FornaxRRSC/RCJ2025_Hardware/README.md

# Hardware

機体に搭載している基板のリポジトリです。  
それぞれの基板の解説は<https://fornax-rrsc.com>に掲載しています。

## 既知の欠陥

最新の基板の欠陥のみ記載
* MainBoard Rev.3のSTM32H723とSTM32F446間のUARTがTX,RX同士をつないでいる
* MainBoard Rev.3のオペアンプのフットプリントが間違っている

## License

**CERN-OHL-P v2**
