FornaxRRSC/RCJ2025_Hardware/TileBoard-Rev2.step

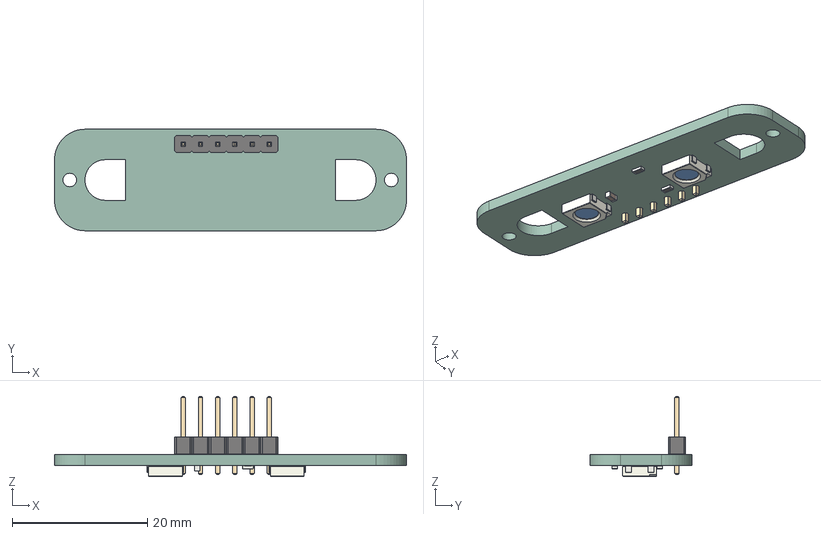
[picture p1: CAD file, 2025-05-13]
TileBoard-Rev2.step
52.0 x 15.0 x 11.8 mm
PinHeader_1x06_P254mm_Vertical
LED_WS2812B_PLCC4_50x50mm_P32mm x 2
R_0603_1608Metric x 2
C_0603_1608Metric
_autosave-Final_PCB
