FornaxRRSC/RCJ2025_Hardware/Final.kicad_pcb

## KiCad design Final.kicad_pcb (2025-05-13)

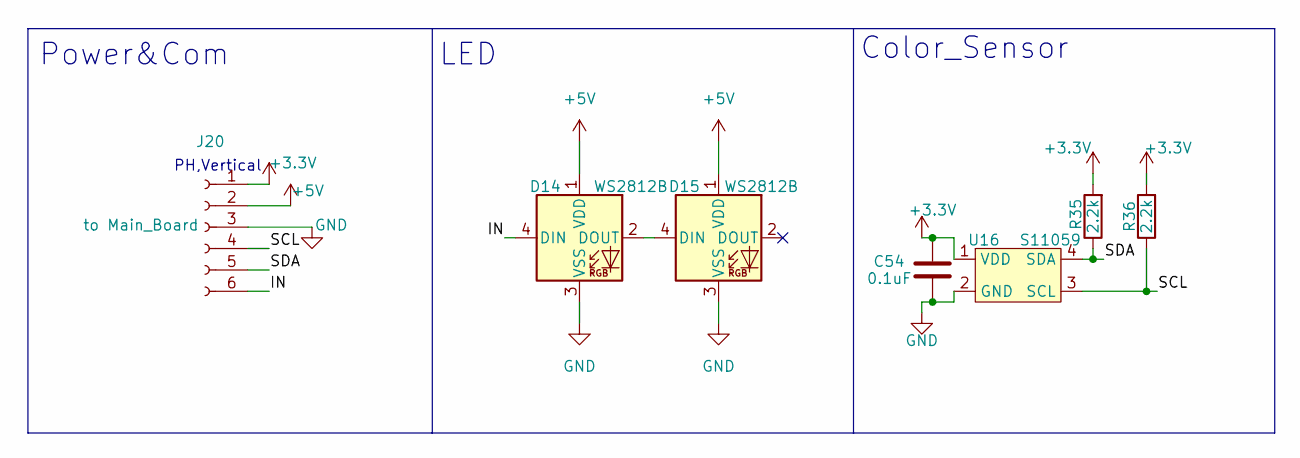
[picture p2: schematic TileBoard.kicad_sch]

Parts:
C54: 0.1uF; C_0603_1608Metric
D14, D15: WS2812B; LED_WS2812B_PLCC4_5.0x5.0mm_P3.2mm
J20: to Main_Board; PinHeader_1x06_P2.54mm_Vertical
R35, R36: 2.2k; R_0603_1608Metric
U16: S11059

Connections:
+3.3V: C54.1, J20.1, R35.2, R36.2, U16.1 (VDD); also elsewhere on the board
+5V: D14.1 (VDD), D15.1 (VDD), J20.2; also elsewhere on the board
/Tile_Board/IN: D14.4 (DIN), J20.6
/Tile_Board/SCL: J20.4, R36.1, U16.3 (SCL)
/Tile_Board/SDA: J20.5, R35.1, U16.4 (SDA)
GND: C54.2, D14.3 (VSS), D15.3 (VSS), J20.3, U16.2 (GND); also elsewhere on the board
unnamed: D14.2 (DOUT), D15.4 (DIN)

Notes on the sheet:
Color_Sensor
LED
Power&Com
PH,Vertical

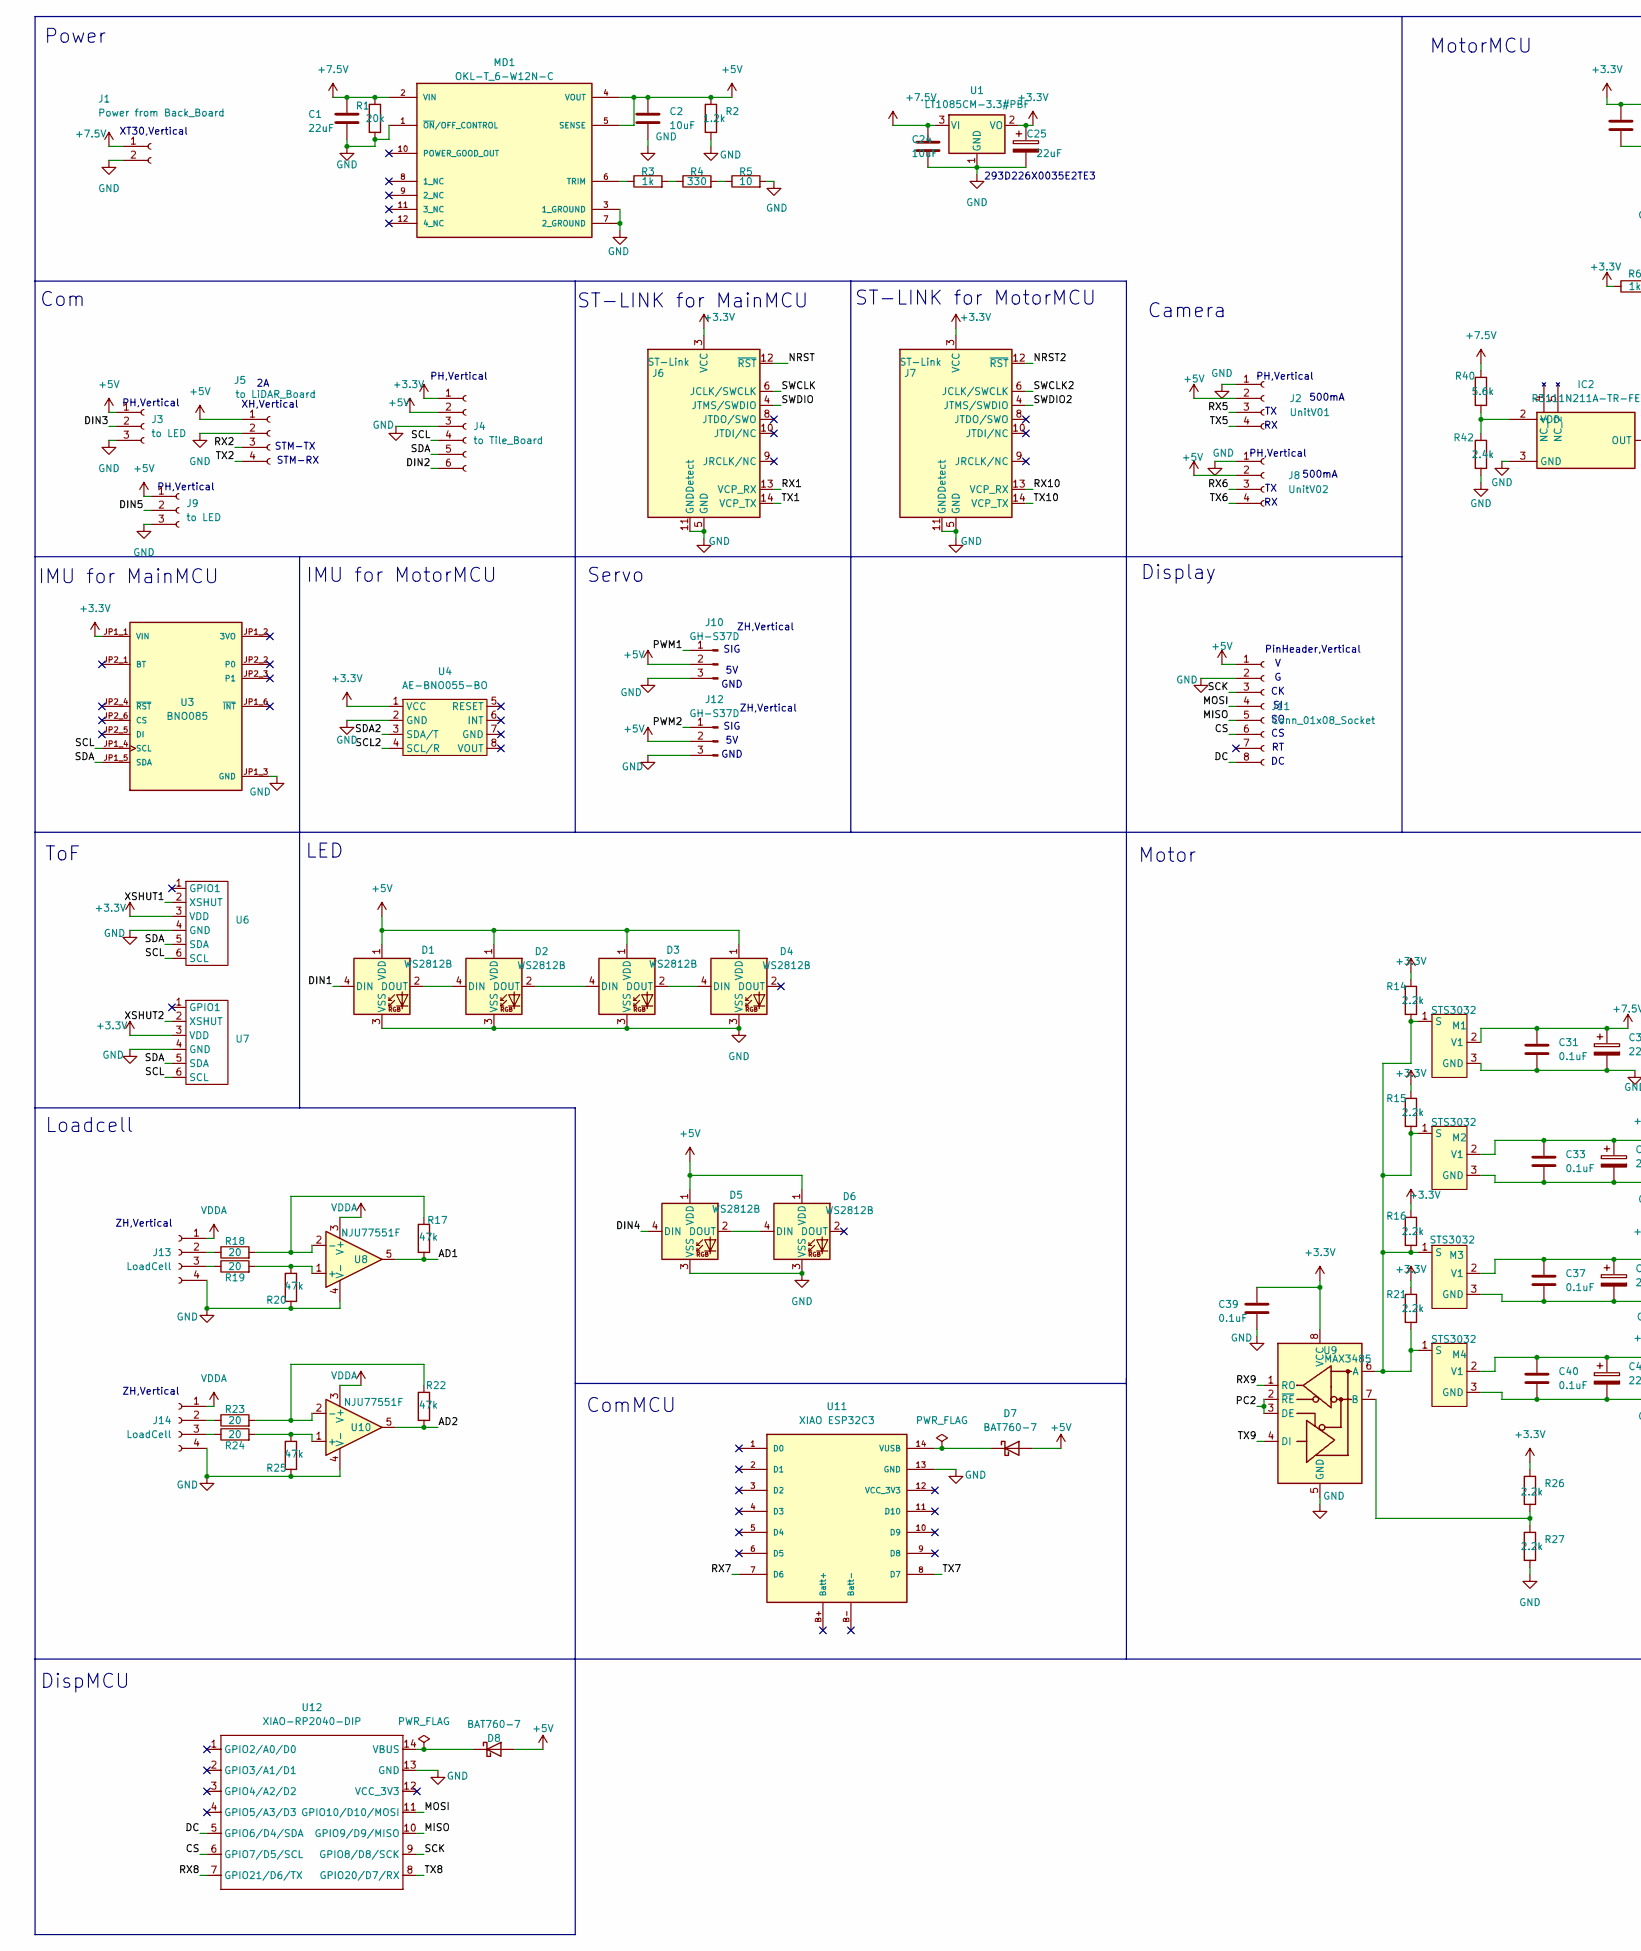
[picture p3: schematic MainBoard.kicad_sch, part in row 1, column 1]

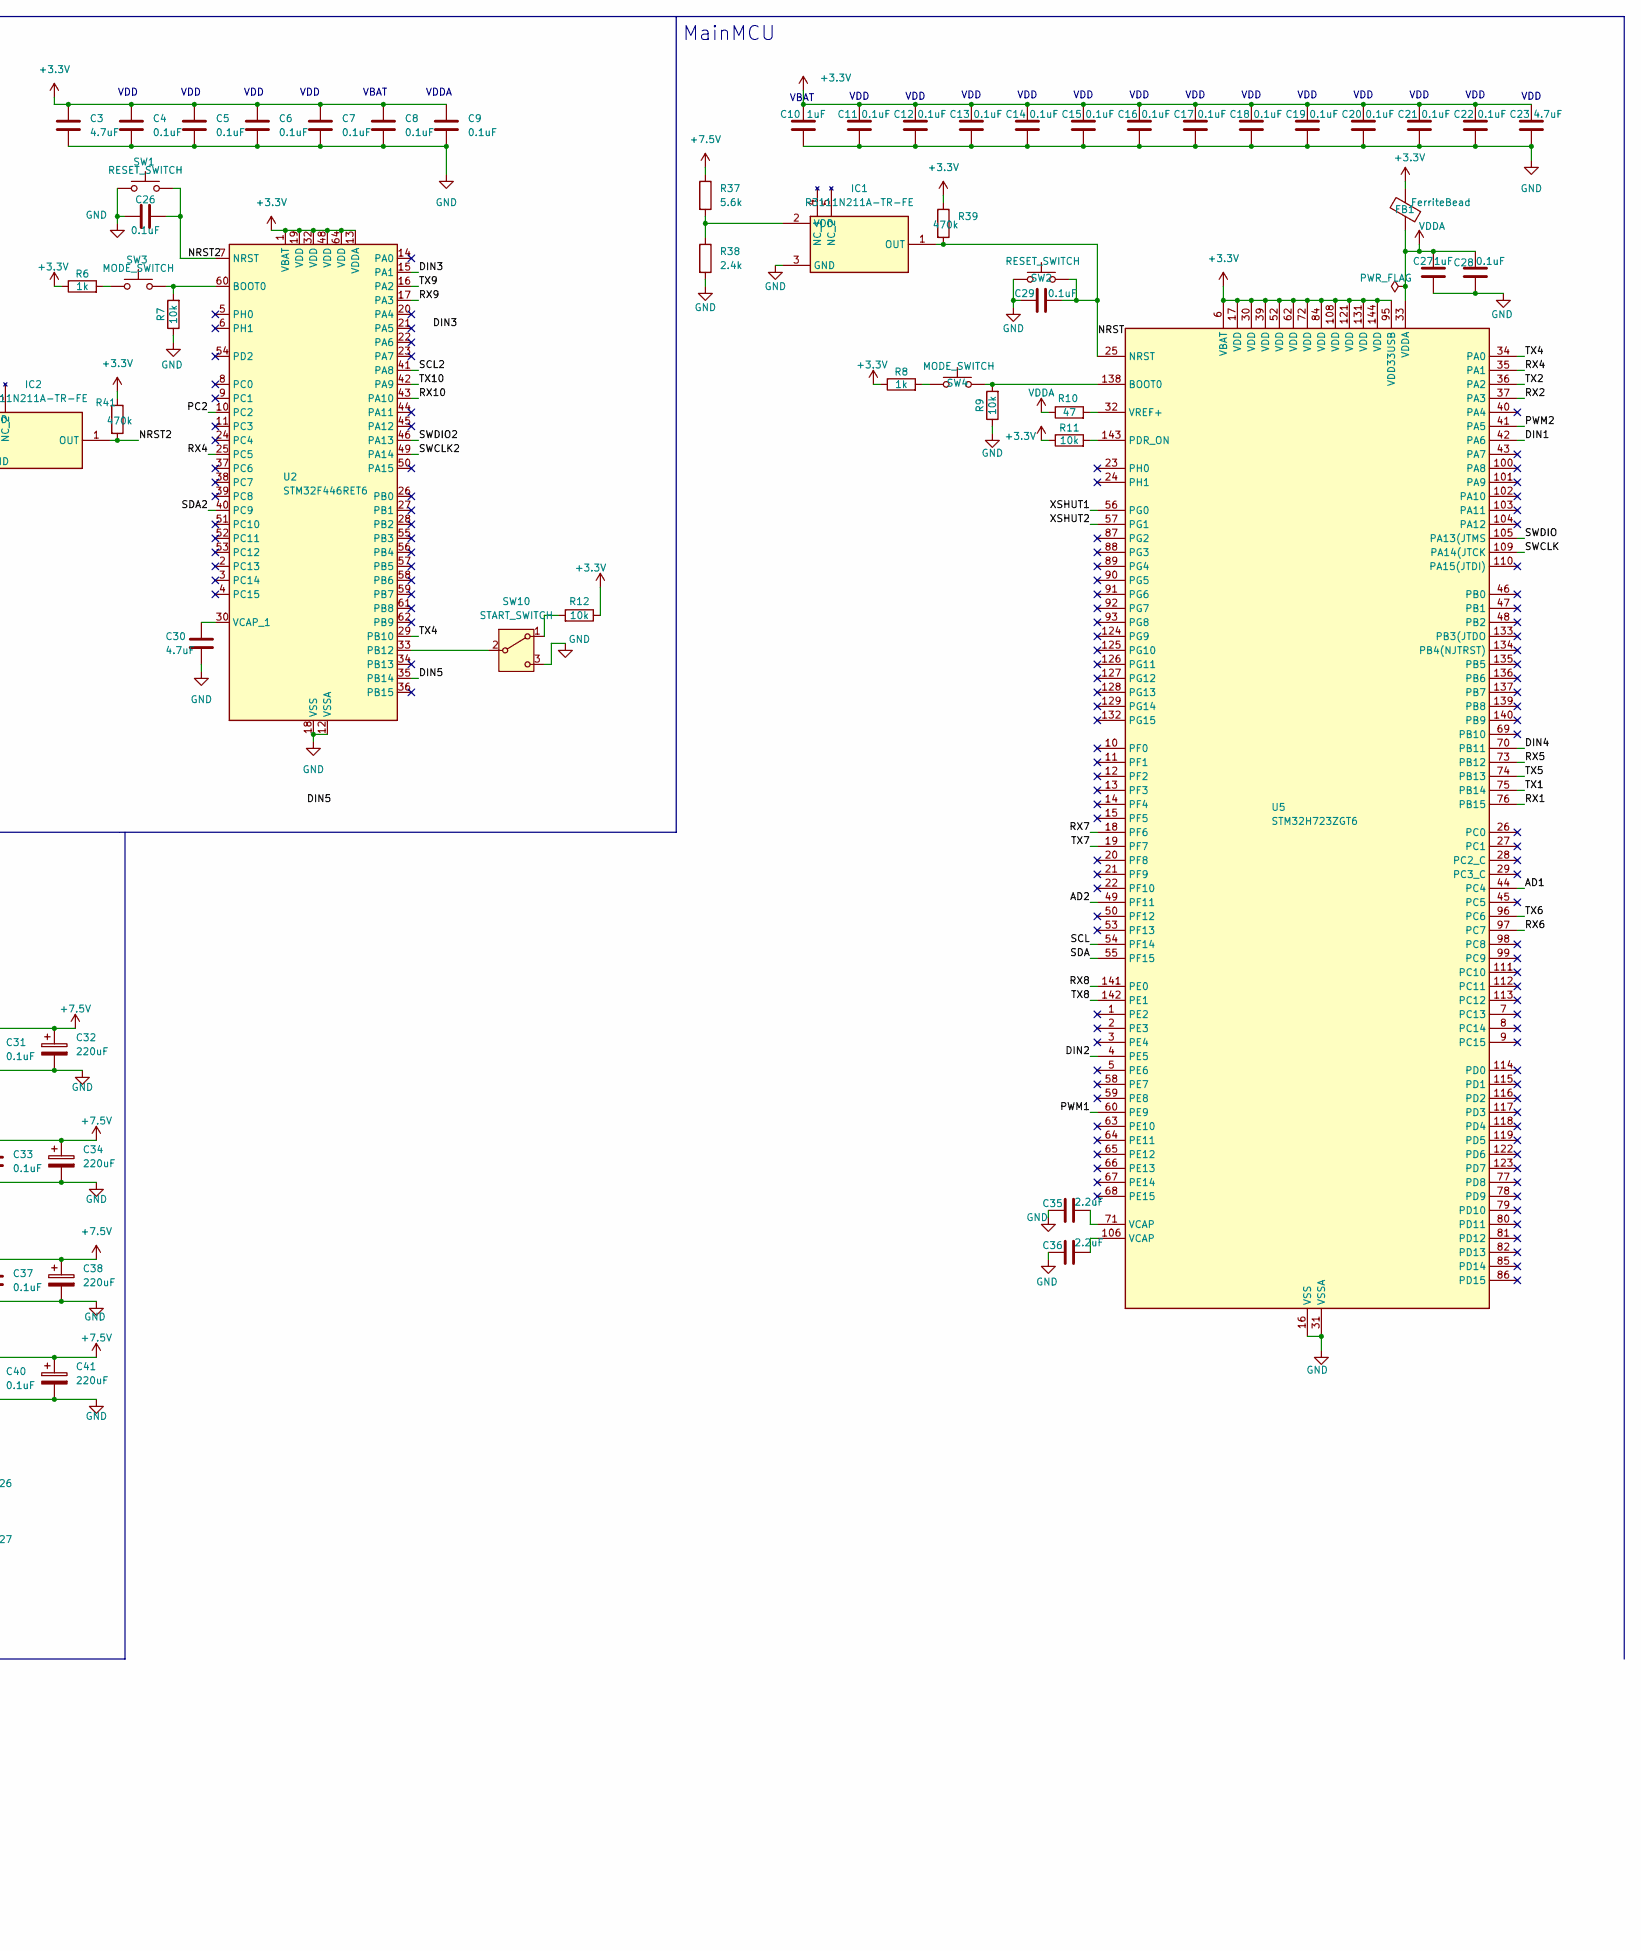
[picture p4: schematic MainBoard.kicad_sch, part in row 1, column 2]

Parts:
C1: 22uF; C_0402_1005Metric
C2: 10uF; C_0402_1005Metric
C3, C23, C30: 4.7uF; C_0402_1005Metric
C4, C5, C6, C7, C8, C9, C11, C12, C13, C14, C15, C16, C17, C18, C19, C20, C21, C22, C28, C31, C33, C37, C39, C40: 0.1uF; C_0402_1005Metric
C10, C27: 1uF; C_0402_1005Metric
C24: 10uF; C_0603_1608Metric_Pad1.08x0.95mm_HandSolder
C25: 22uF; CP_EIA-7343-15_Kemet-W
C26, C29: 0.1uF; C_0603_1608Metric_Pad1.08x0.95mm_HandSolder
C32, C34, C38, C41: 220uF; CP_Elec_10x10
C35, C36: 2.2uF; C_0402_1005Metric
D1, D2, D3, D4, D5, D6: WS2812B; LED_WS2812B_PLCC4_5.0x5.0mm_P3.2mm
D7, D8: BAT760-7; D_SOD-323F
FB1: FerriteBead; L_0603_1608Metric
IC1, IC2: R3111N211A-TR-FE; SOT95P280X130-5N; Mouser Part Number 848-R3111N211A-TR-FE
J1: Power from Back_Board; AMASS_XT30U-M_1x02_P5.0mm_Vertical
J2: UnitV01; JST_PH_B4B-PH-K_1x04_P2.00mm_Vertical
J3, J9: to LED; JST_PH_B3B-PH-K_1x03_P2.00mm_Vertical
J4: to Tile_Board; PinSocket_1x06_P2.54mm_Vertical
J5: to LiDAR_Board; JST_XH_B4B-XH-A_1x04_P2.50mm_Vertical
J6, J7: ST-Link; CONN14_3220-14_CNC
J8: UnitV02; JST_PH_B4B-PH-K_1x04_P2.00mm_Vertical
J10, J12: GH-S37D; JST_ZH_B3B-ZR_1x03_P1.50mm_Vertical
J11: Conn_01x08_Socket; PinSocket_1x08_P2.54mm_Vertical
J13, J14: LoadCell; JST_ZH_B4B-ZR_1x04_P1.50mm_Vertical
M1, M2, M3, M4: STS3032; JST_XH_B3B-XH-A_1x03_P2.50mm_Vertical
MD1: OKL-T_6-W12N-C; MURATA_OKL-T-6-W12N-C_0; MOUSER_PART_NUMBER 580-OKL-T/6-W12N-C; MOUSER_DESCRIPTION Non-Isolated DC/DC Converters 12Vin .59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
R1: 20k; R_0402_1005Metric
R2: 1.2k; R_0402_1005Metric
R3: 1k; R_0402_1005Metric
R4: 330; R_0402_1005Metric
R5: 10; R_0402_1005Metric
R6, R8: 1k; R_0603_1608Metric_Pad0.98x0.95mm_HandSolder
R7, R9: 10k; R_0603_1608Metric_Pad0.98x0.95mm_HandSolder
R10: 47; R_0402_1005Metric
R11, R12: 10k; R_0402_1005Metric
R14, R15, R16, R21, R26, R27: 2.2k; R_0402_1005Metric
R17, R20, R22, R25: 47k; R_0402_1005Metric
R18, R19, R23, R24: 20; R_0402_1005Metric
R37, R40: 5.6k; R_0402_1005Metric
R38, R42: 2.4k; R_0402_1005Metric
R39, R41: 470k; R_0402_1005Metric
SW1, SW2: RESET_SWITCH; SW_SKRPACE010
SW3, SW4: MODE_SWITCH; SW_SKRPACE010
SW10: START_SWITCH; B12AP_NKK
U1: LT1085CM-3.3#PBF; TO-263-3_TabPin2
U2: STM32F446RET6; LQFP-64_10x10mm_P0.5mm
U3: BNO085; PARTREV 2021-03-16
U4: AE-BNO055-BO
U5: STM32H723ZGT6; LQFP-144_20x20mm_P0.5mm
U6, U7: PinSocket_1x06_P2.54mm_Vertical
U8, U10: NJU77551F; SOT-23-5
U9: MAX3485; SOIC-8_3.9x4.9mm_P1.27mm
U11: XIAO ESP32C3; XIAO-14P-DIP
U12: XIAO-RP2040-DIP; XIAO-14P-DIP

Connections:
+3.3V: C3.1, C4.1, C5.1, C6.1, C7.1, C8.1, C9.1, C10.1, C11.1, C12.1, C13.1, C14.1, C15.1, C16.1, C17.1, C18.1, C19.1, C20.1, C21.1, C22.1, C23.1, C25.1, C39.1, FB1.2, J4.1, J6.3 (VCC), J7.3 (VCC), R6.1, R8.1, R11.1, R12.1, R14.1, R15.1, R16.1, R21.1, R26.1, R39.1, R41.1, U1.2 (VO), U2.1 (VBAT), U2.13 (VDDA), U2.19 (VDD), U2.32 (VDD), U2.48 (VDD), U2.64 (VDD), U3.JP1_1 (VIN), U4.1 (VCC), U5.6 (VBAT), U5.17 (VDD), U5.30 (VDD), U5.39 (VDD), U5.52 (VDD), U5.62 (VDD), U5.72 (VDD), U5.84 (VDD), U5.95 (VDD33USB), U5.108 (VDD), U5.121 (VDD), U5.131 (VDD), U5.144 (VDD), U6.3 (VDD), U7.3 (VDD), U9.8 (VCC); also elsewhere on the board
+5V: C2.1, D1.1 (VDD), D2.1 (VDD), D3.1 (VDD), D4.1 (VDD), D5.1 (VDD), D6.1 (VDD), D7.2 (A), D8.2 (A), J2.2, J3.1, J4.2, J5.1, J8.2, J9.1, J10.2, J11.1, J12.2, MD1.4 (VOUT), MD1.5 (SENSE), R2.1; also elsewhere on the board
+7.5V: C1.1, C24.1, C31.1, C32.1, C33.1, C34.1, C37.1, C38.1, C40.1, C41.1, J1.1, M1.2 (V1), M2.2 (V1), M3.2 (V1), M4.2 (V1), MD1.2 (VIN), R1.1, R37.1, R40.1, U1.3 (VI); also elsewhere on the board
/Main_Board/AD1: R17.2, U5.44 (PC4), U8.5
/Main_Board/AD2: R22.2, U5.49 (PF11), U10.5
/Main_Board/CS: J11.6, U12.6 (GPIO7/D5/SCL)
/Main_Board/DC: J11.8, U12.5 (GPIO6/D4/SDA)
/Main_Board/DIN1: D1.4 (DIN), U5.42 (PA6)
/Main_Board/DIN2: J4.6, U5.4 (PE5)
/Main_Board/DIN3: J3.2, U2.15 (PA1)
/Main_Board/DIN4: D5.4 (DIN), U5.70 (PB11)
/Main_Board/DIN5: J9.2, U2.35 (PB14)
/Main_Board/MISO: J11.5, U12.10 (GPIO9/D9/MISO)
/Main_Board/MOSI: J11.4, U12.11 (GPIO10/D10/MOSI)
/Main_Board/NRST: C29.2, IC1.1 (OUT), J6.12 (~RST), R39.2, SW2.2, U5.25 (NRST)
/Main_Board/NRST2: C26.2, IC2.1 (OUT), J7.12 (~RST), R41.2, SW1.2, U2.7 (NRST)
/Main_Board/PC2: U2.10 (PC2), U9.2 (~RE), U9.3 (DE)
/Main_Board/PWM1: J10.1, U5.60 (PE9)
/Main_Board/PWM2: J12.1, U5.41 (PA5)
/Main_Board/RX1: J6.13 (VCP_RX), U5.76 (PB15)
/Main_Board/RX2: J5.3, U5.37 (PA3)
/Main_Board/RX4: U2.25 (PC5), U5.35 (PA1)
/Main_Board/RX5: J2.3, U5.73 (PB12)
/Main_Board/RX6: J8.3, U5.97 (PC7)
/Main_Board/RX7: U5.18 (PF6), U11.7 (D6)
/Main_Board/RX8: U5.141 (PE0), U12.7 (GPIO21/D6/TX)
/Main_Board/RX9: U2.17 (PA3), U9.1 (RO)
/Main_Board/RX10: J7.13 (VCP_RX), U2.43 (PA10)
/Main_Board/SCK: J11.3, U12.9 (GPIO8/D8/SCK)
/Main_Board/SCL: J4.4, U3.JP1_4 (SCL), U5.54 (PF14), U6.6 (SCL), U7.6 (SCL)
/Main_Board/SCL2: U2.41 (PA8), U4.4 (SCL/R)
/Main_Board/SDA: J4.5, U3.JP1_5 (SDA), U5.55 (PF15), U6.5 (SDA), U7.5 (SDA)
/Main_Board/SDA2: U2.40 (PC9), U4.3 (SDA/T)
/Main_Board/SWCLK: J6.6 (JCLK/SWCLK), U5.109 (PA14(JTCK)
/Main_Board/SWCLK2: J7.6 (JCLK/SWCLK), U2.49 (PA14)
/Main_Board/SWDIO: J6.4 (JTMS/SWDIO), U5.105 (PA13(JTMS)
/Main_Board/SWDIO2: J7.4 (JTMS/SWDIO), U2.46 (PA13)
/Main_Board/TX1: J6.14 (VCP_TX), U5.75 (PB14)
/Main_Board/TX2: J5.4, U5.36 (PA2)
/Main_Board/TX4: U2.29 (PB10), U5.34 (PA0)
/Main_Board/TX5: J2.4, U5.74 (PB13)
/Main_Board/TX6: J8.4, U5.96 (PC6)
/Main_Board/TX7: U5.19 (PF7), U11.8 (D7)
/Main_Board/TX8: U5.142 (PE1), U12.8 (GPIO20/D7/RX)
/Main_Board/TX9: U2.16 (PA2), U9.4 (DI)
/Main_Board/TX10: J7.14 (VCP_TX), U2.42 (PA9)
/Main_Board/XSHUT1: U5.56 (PG0), U6.2 (XSHUT)
/Main_Board/XSHUT2: U5.57 (PG1), U7.2 (XSHUT)
GND: C1.2, C2.2, C3.2, C4.2, C5.2, C6.2, C7.2, C8.2, C9.2, C10.2, C11.2, C12.2, C13.2, C14.2, C15.2, C16.2, C17.2, C18.2, C19.2, C20.2, C21.2, C22.2, C23.2, C24.2, C25.2, C26.1, C27.2, C28.2, C29.1, C30.2, C31.2, C32.2, C33.2, C34.2, C35.1, C36.1, C37.2, C38.2, C39.2, C40.2, C41.2, D1.3 (VSS), D2.3 (VSS), D3.3 (VSS), D4.3 (VSS), D5.3 (VSS), D6.3 (VSS), IC1.3 (GND), IC2.3 (GND), J1.2, J2.1, J3.3, J4.3, J5.2, J6.5 (GND), J6.7 (GND), J6.11 (GNDDetect), J7.5 (GND), J7.7 (GND), J7.11 (GNDDetect), J8.1, J9.3, J10.3, J11.2, J12.3, J13.4, J14.4, M1.3 (GND), M2.3 (GND), M3.3 (GND), M4.3 (GND), MD1.1 (~ON/OFF_CONTROL), MD1.3 (1_GROUND), MD1.7 (2_GROUND), R1.2, R2.2, R5.2, R7.1, R9.1, R20.2, R25.2, R27.2, R38.2, R42.2, SW1.1, SW2.1, SW10.3 (C), U1.1 (GND), U2.12 (VSSA), U2.18 (VSS), U2.31 (VSS), U2.47 (VSS), U2.63 (VSS), U3.JP1_3 (GND), U4.2 (GND), U5.16 (VSS), U5.31 (VSSA), U5.38 (VSS), U5.51 (VSS), U5.61 (VSS), U5.83 (VSS), U5.94 (VSS), U5.107 (VSS), U5.120 (VSS), U5.130 (VSS), U6.4 (GND), U7.4 (GND), U8.4 (V-), U9.5 (GND), U10.4 (V-), U11.13 (GND), U12.13 (GND); also elsewhere on the board
unnamed: C35.2, U5.71 (VCAP)
unnamed: C36.2, U5.106 (VCAP)
unnamed: D1.2 (DOUT), D2.4 (DIN)
unnamed: D2.2 (DOUT), D3.4 (DIN)
unnamed: D3.2 (DOUT), D4.4 (DIN)
unnamed: D5.2 (DOUT), D6.4 (DIN)
unnamed: D7.1 (K), U11.14 (VUSB)
unnamed: D8.1 (K), U12.14 (VBUS)
unnamed: IC1.2 (VDD), R37.2, R38.1
unnamed: IC2.2 (VDD), R40.2, R42.1
unnamed: J13.2, R18.1
unnamed: J13.3, R19.1
unnamed: J14.2, R23.1
unnamed: J14.3, R24.1
unnamed: M1.1 (S), M2.1 (S), M3.1 (S), M4.1 (S), R14.2, R15.2, R16.2, R21.2, U9.6 (A)
unnamed: MD1.6 (TRIM), R3.1
unnamed: R3.2, R4.1
unnamed: R4.2, R5.1
unnamed: R6.2, SW3.1
unnamed: R8.2, SW4.1
unnamed: R12.2, SW10.1 (A)
unnamed: SW10.2 (B), U2.33 (PB12)
unnamed: R7.2, SW3.2, U2.60 (BOOT0)
unnamed: C30.1, U2.30 (VCAP_1)
unnamed: R9.2, SW4.2, U5.138 (BOOT0)
unnamed: R11.2, U5.143 (PDR_ON)
unnamed: R10.2, U5.32 (VREF+)
unnamed: R19.2, R20.1, U8.1 (+)
unnamed: R17.1, R18.2, U8.2 (-)
unnamed: R26.2, R27.1, U9.7 (B)
unnamed: R24.2, R25.1, U10.1 (+)
unnamed: R22.1, R23.2, U10.2 (-)
VDDA: C27.1, C28.1, FB1.1, J13.1, J14.1, R10.1, U5.33 (VDDA), U8.3 (V+), U10.3 (V+)

Notes on the sheet:
VDD
MainMCU
LED
293D226X0035E2TE3
PH,Vertical
GND
VBAT
Servo
500mA
ZH,Vertical
STM-TX
XT30,Vertical
SIG
MotorMCU
ST-LINK for MainMCU
Loadcell
DispMCU
Motor
PinHeader,Vertical
ComMCU
STM-RX
IMU for MainMCU
ST-LINK for MotorMCU
Display
XH,Vertical
Camera
ToF
Power
IMU for MotorMCU
VDDA
Com

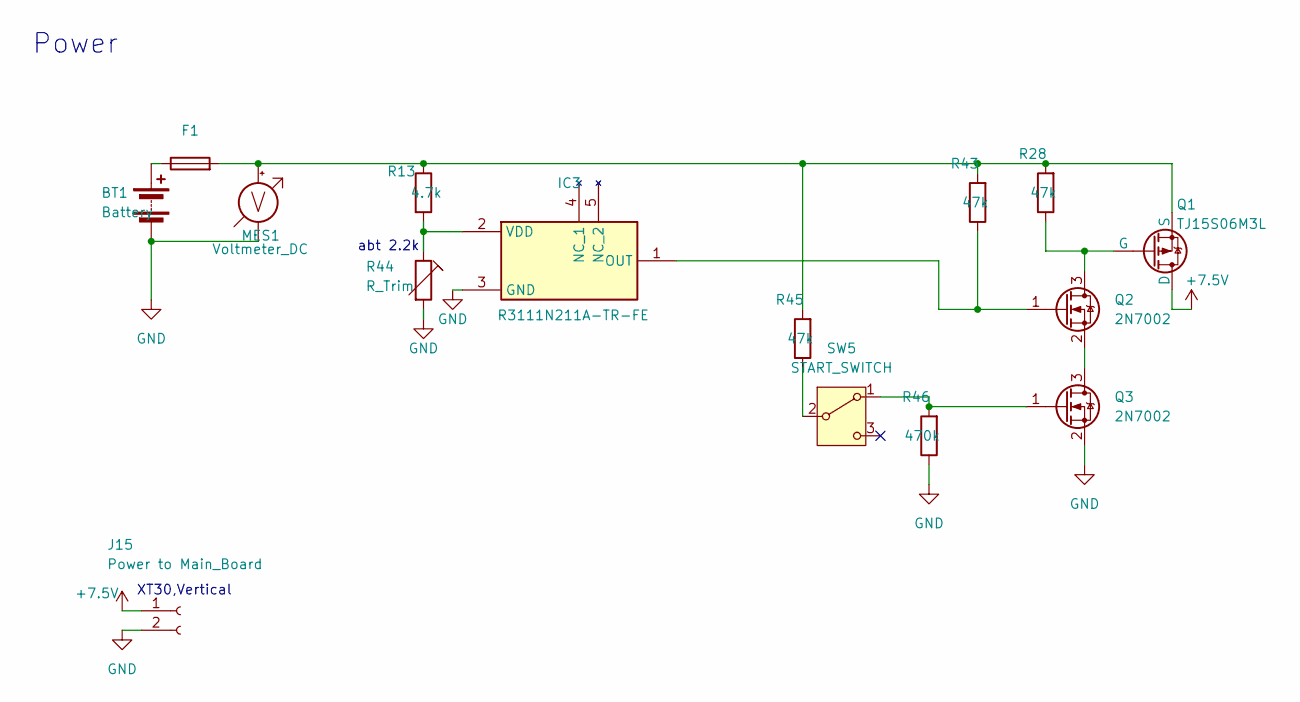
[picture p5: schematic BackBoard.kicad_sch]

Parts:
BT1: Battery; AMASS_XT30U-M_1x02_P5.0mm_Vertical
F1: 0451015.MRL; 0451Series_LTF
IC3: R3111N211A-TR-FE; SOT95P280X130-5N; Mouser Part Number 848-R3111N211A-TR-FE
J15: Power to Main_Board; AMASS_XT30U-M_1x02_P5.0mm_Vertical
MES1: Voltmeter_DC; JST_PH_B2B-PH-K_1x02_P2.00mm_Vertical
Q1: TJ15S06M3L; TO-252-2
Q2, Q3: 2N7002; SOT-23
R13: 4.7k; R_0603_1608Metric_Pad0.98x0.95mm_HandSolder
R28, R43, R45: 47k; R_0603_1608Metric_Pad0.98x0.95mm_HandSolder
R44: R_Trim; TRIM_3362P-1-103LF
R46: 470k; R_0603_1608Metric_Pad0.98x0.95mm_HandSolder
SW5: START_SWITCH; B12AP_NKK

Connections:
+7.5V: J15.1, Q1.1 (D); also elsewhere on the board
GND: BT1.2 (-), IC3.3 (GND), J15.2, MES1.1 (-), Q3.2 (S), R44.2, R46.1; also elsewhere on the board
unnamed: BT1.1 (+), F1.1
unnamed: IC3.1 (OUT), Q2.1 (G), R43.1
unnamed: IC3.2 (VDD), R13.2, R44.1
unnamed: F1.2, MES1.2 (+), Q1.3 (S), R13.1, R28.2, R43.2, R45.2
unnamed: Q1.2 (G), Q2.3 (D), R28.1
unnamed: Q2.2 (S), Q3.3 (D)
unnamed: Q3.1 (G), R46.2, SW5.1 (A)
unnamed: R45.1, SW5.2 (B)

Notes on the sheet:
Power
abt 2.2k
XT30,Vertical

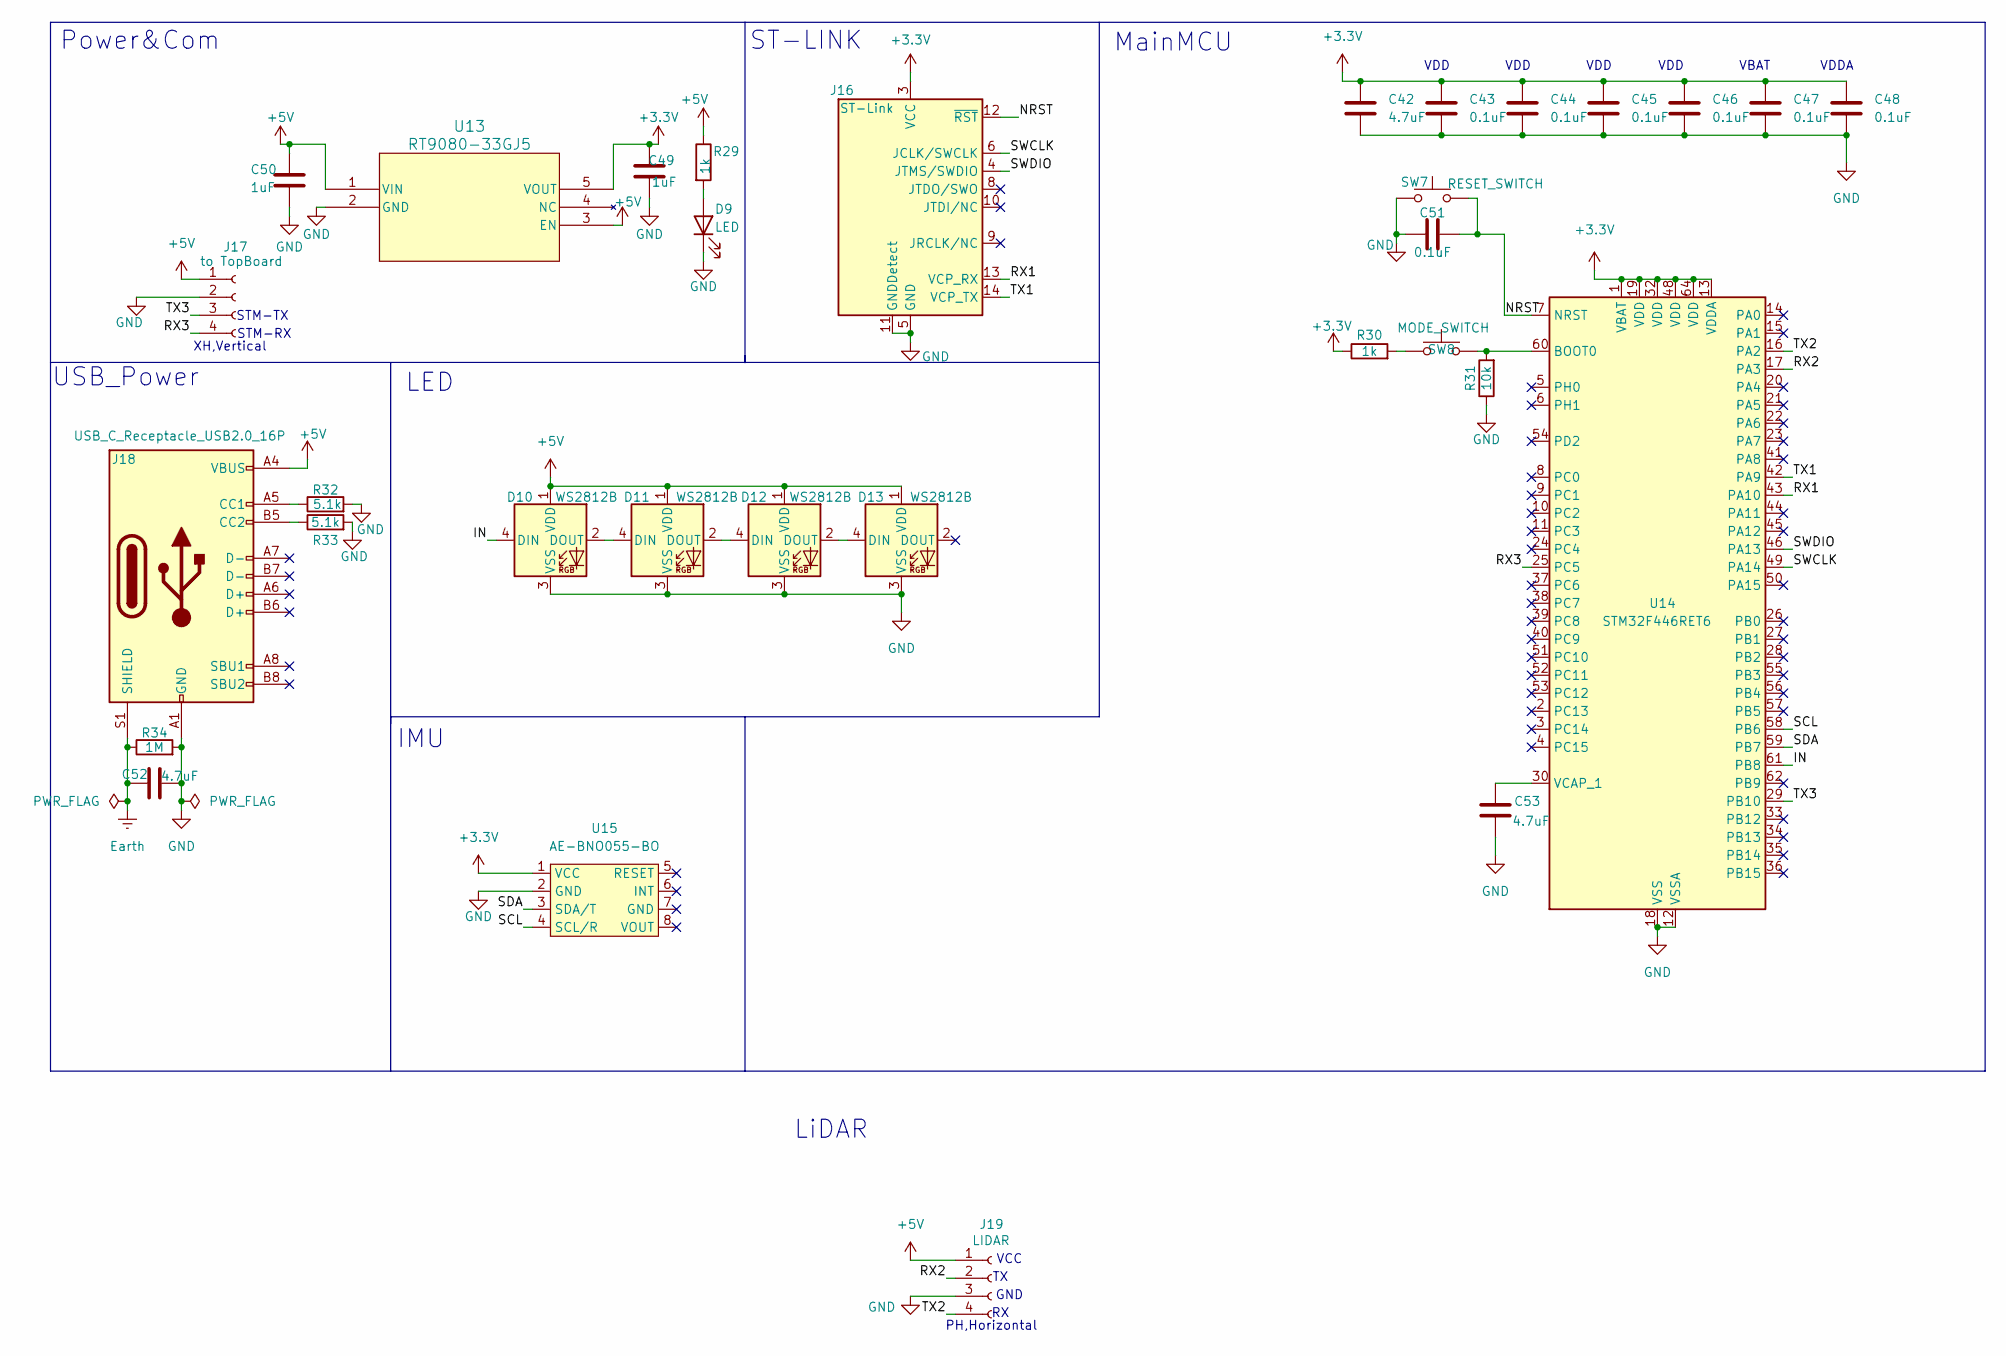
[picture p6: schematic LidarBoard.kicad_sch, LiDAR_Board_Rev.3]

Parts:
C42, C52, C53: 4.7uF; C_0603_1608Metric
C43, C44, C45, C46, C47, C48: 0.1uF; C_0603_1608Metric
C49, C50: 1uF; C_0603_1608Metric
C51: 0.1uF; C_0603_1608Metric_Pad1.08x0.95mm_HandSolder
D9: LED; LED_0603_1608Metric
D10, D11, D12, D13: WS2812B; LED_WS2812B_PLCC4_5.0x5.0mm_P3.2mm
J16: ST-Link; CONN14_3220-14_CNC
J17: to TopBoard; JST_XH_B4B-XH-A_1x04_P2.50mm_Vertical
J18: USB_C_Receptacle_USB2.0_16P; USB_C_Receptacle_G-Switch_GT-USB-7010ASV
J19: LIDAR; JST_PH_S4B-PH-K_1x04_P2.00mm_Horizontal
R29: 1k; R_0603_1608Metric
R30: 1k; R_0603_1608Metric_Pad0.98x0.95mm_HandSolder
R31: 10k; R_0603_1608Metric_Pad0.98x0.95mm_HandSolder
R32, R33: 5.1k; R_0603_1608Metric
R34: 1M; R_0603_1608Metric
SW7: RESET_SWITCH; SW_SKRPACE010
SW8: MODE_SWITCH; SW_SKRPACE010
U13: RT9080-33GJ5; TSOT-23-5
U14: STM32F446RET6; LQFP-64_10x10mm_P0.5mm
U15: AE-BNO055-BO

Connections:
+3.3V: C42.1, C43.1, C44.1, C45.1, C46.1, C47.1, C48.1, C49.1, J16.3 (VCC), R30.1, U13.5 (VOUT), U14.1 (VBAT), U14.13 (VDDA), U14.19 (VDD), U14.32 (VDD), U14.48 (VDD), U14.64 (VDD), U15.1 (VCC); also elsewhere on the board
+5V: C50.1, D10.1 (VDD), D11.1 (VDD), D12.1 (VDD), D13.1 (VDD), J17.1, J18.A4 (VBUS), J18.A9 (VBUS), J18.B4 (VBUS), J18.B9 (VBUS), J19.1, R29.1, U13.1 (VIN), U13.3 (EN); also elsewhere on the board
/LiDAR_Board/IN: D10.4 (DIN), U14.61 (PB8)
/LiDAR_Board/NRST: C51.2, J16.12 (~RST), SW7.2, U14.7 (NRST)
/LiDAR_Board/RX1: J16.13 (VCP_RX), U14.43 (PA10)
/LiDAR_Board/RX2: J19.2, U14.17 (PA3)
/LiDAR_Board/RX3: J17.4, U14.25 (PC5)
/LiDAR_Board/SCL: U14.58 (PB6), U15.4 (SCL/R)
/LiDAR_Board/SDA: U14.59 (PB7), U15.3 (SDA/T)
/LiDAR_Board/SWCLK: J16.6 (JCLK/SWCLK), U14.49 (PA14)
/LiDAR_Board/SWDIO: J16.4 (JTMS/SWDIO), U14.46 (PA13)
/LiDAR_Board/TX1: J16.14 (VCP_TX), U14.42 (PA9)
/LiDAR_Board/TX2: J19.4, U14.16 (PA2)
/LiDAR_Board/TX3: J17.3, U14.29 (PB10)
Earth: C52.1, J18.S1 (SHIELD), R34.1
GND: C42.2, C43.2, C44.2, C45.2, C46.2, C47.2, C48.2, C49.2, C50.2, C51.1, C52.2, C53.2, D9.1 (K), D10.3 (VSS), D11.3 (VSS), D12.3 (VSS), D13.3 (VSS), J16.5 (GND), J16.7 (GND), J16.11 (GNDDetect), J17.2, J18.A1 (GND), J18.A12 (GND), J18.B1 (GND), J18.B12 (GND), J19.3, R31.1, R32.2, R33.2, R34.2, SW7.1, U13.2 (GND), U14.12 (VSSA), U14.18 (VSS), U14.31 (VSS), U14.47 (VSS), U14.63 (VSS), U15.2 (GND); also elsewhere on the board
unnamed: D9.2 (A), R29.2
unnamed: D10.2 (DOUT), D11.4 (DIN)
unnamed: D11.2 (DOUT), D12.4 (DIN)
unnamed: D12.2 (DOUT), D13.4 (DIN)
unnamed: J18.A5 (CC1), R32.1
unnamed: J18.B5 (CC2), R33.1
unnamed: R30.2, SW8.1
unnamed: R31.2, SW8.2, U14.60 (BOOT0)
unnamed: C53.1, U14.30 (VCAP_1)

Notes on the sheet:
STM-TX
VDD
VCC
MainMCU
VDDA
STM-RX
PH,Horizontal
IMU
LiDAR
LED
GND
VBAT
USB_Power
Power&Com
XH,Vertical
ST-LINK

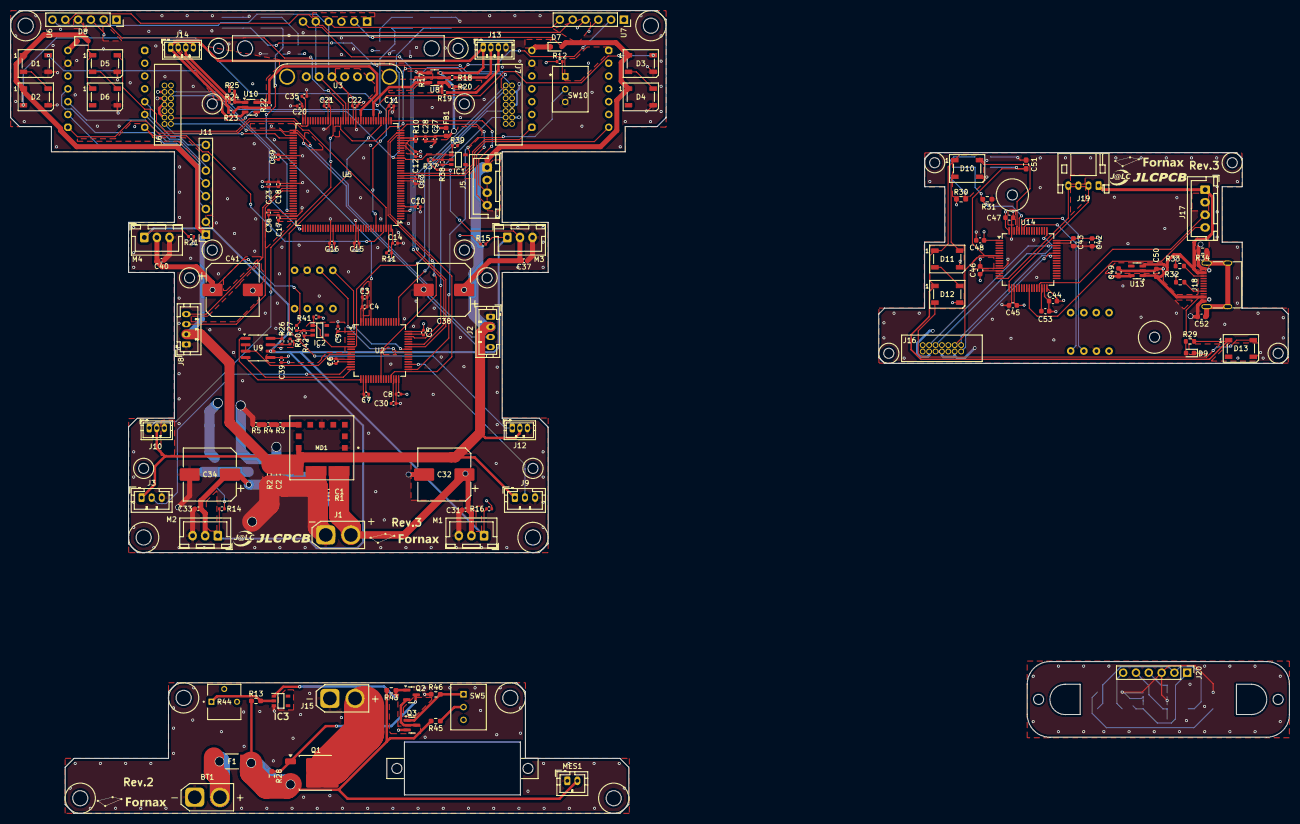
[picture p7: board Final.kicad_pcb from above]

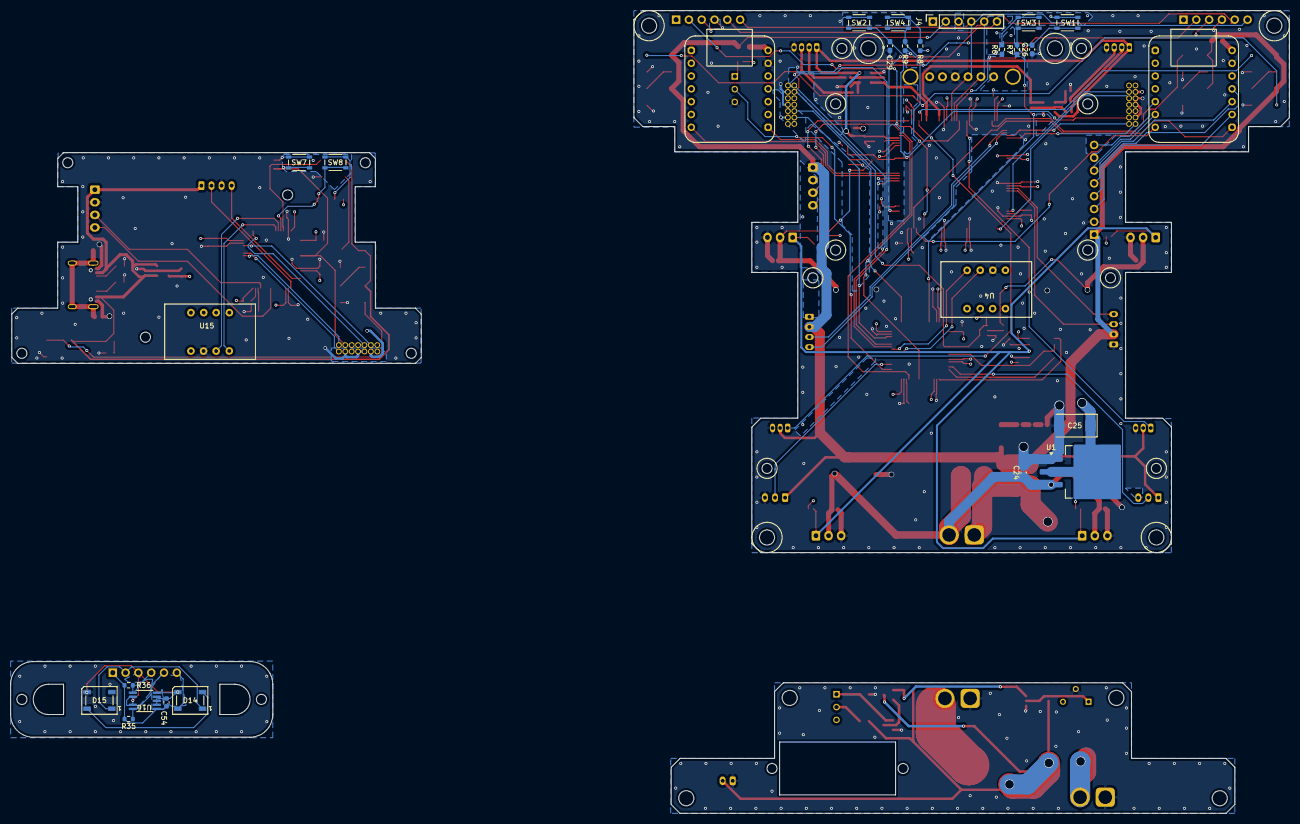
[picture p8: board Final.kicad_pcb from below]

Board: 4 copper layers, 253.6 x 159.2 mm, 174 parts (26 on the bottom side), 116 nets.
