FornaxRRSC/RCJ2025_Hardware/Rev.1.kicad_pcb

## KiCad design Rev.1.kicad_pcb (2025-02-04)

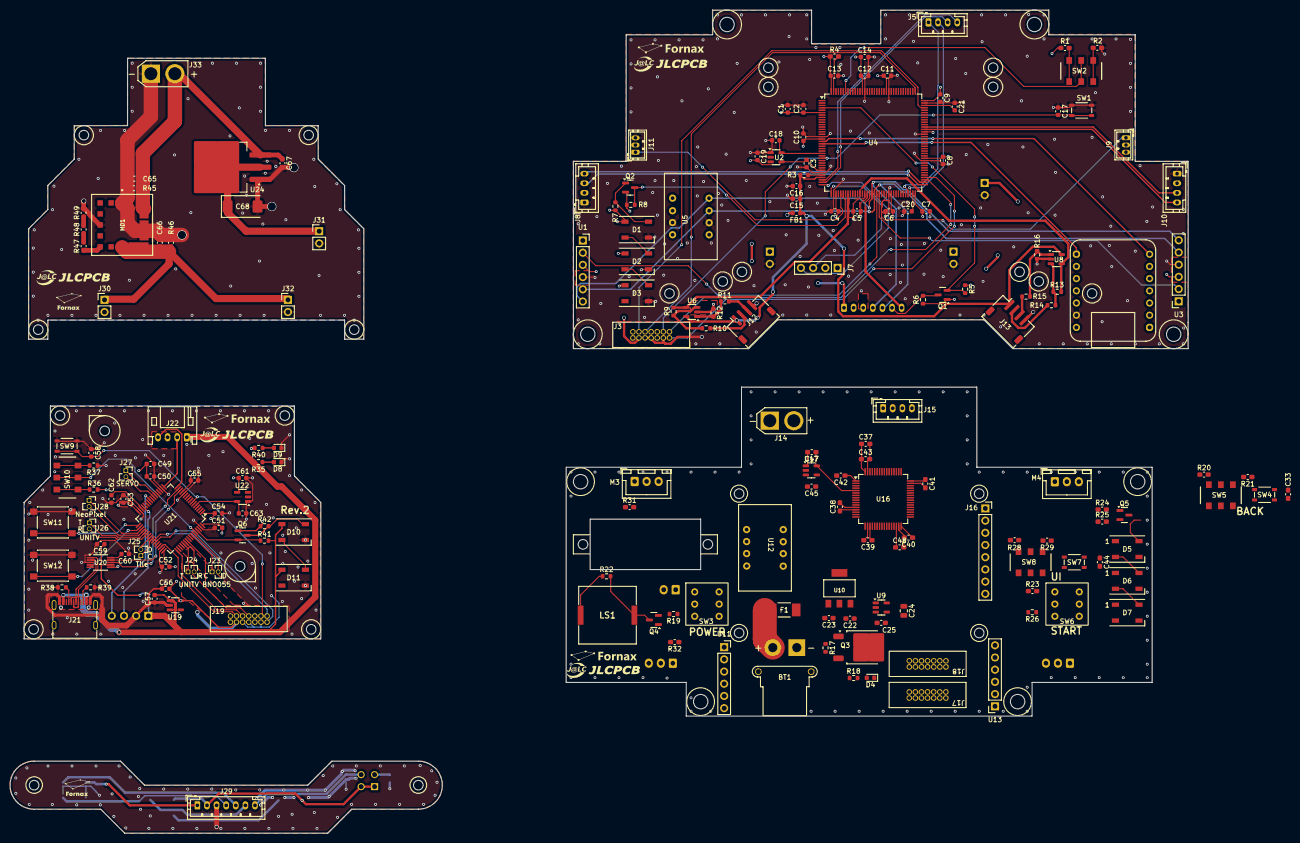
[picture p9: board Rev.1.kicad_pcb from above]

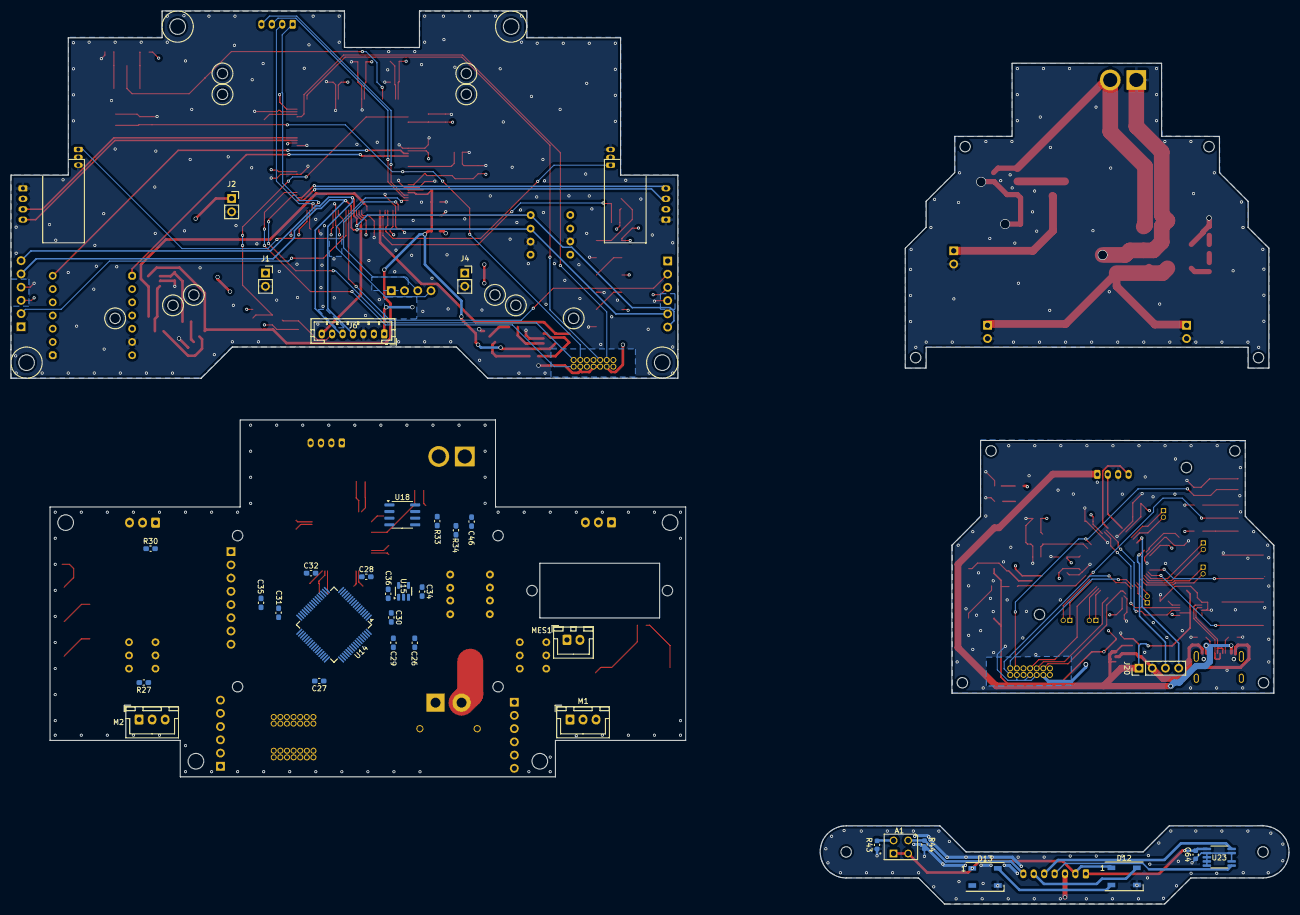
[picture p10: board Rev.1.kicad_pcb from below]

Board: 4 copper layers, 245.3 x 171.4 mm, 216 parts (33 on the bottom side), 159 nets.

Parts:
A1: RPR-220; PHODET_RPR-220
BT1: Battery; AMASS_XT30PW-F_1x02_P2.50mm_Horizontal
C1, C15, C56, C57: 1uF; C_0603_1608Metric
C2, C3, C4, C5, C6, C7, C8, C9, C10, C11, C12, C13, C16, C17, C19, C50, C51, C52, C53, C54, C55, C58, C59, C60, C61, C64: 0.1uF; C_0603_1608Metric
C14, C49, C62: 4.7uF; C_0603_1608Metric
C18, C63: 15pF; C_0603_1608Metric
C20, C21: 2.2uF; C_0603_1608Metric
C22, C66, C67: 10uF; C_0603_1608Metric_Pad1.08x0.95mm_HandSolder
C23, C65: 22uF; C_0603_1608Metric_Pad1.08x0.95mm_HandSolder
C24: 2.2uF; C_0805_2012Metric
C25: 470pF; C_0603_1608Metric_Pad1.08x0.95mm_HandSolder
C26, C35, C37, C48: 4.7uF; C_0603_1608Metric_Pad1.08x0.95mm_HandSolder
C27, C28, C29, C30, C31, C32, C33, C34, C38, C39, C40, C41, C42, C43, C44, C45, C46: 0.1uF; C_0603_1608Metric_Pad1.08x0.95mm_HandSolder
C36, C47: 15pF; C_0603_1608Metric_Pad1.08x0.95mm_HandSolder
C68: 22uF; CP_EIA-7343-15_Kemet-W
D1, D2, D3, D5, D6, D7, D10, D11, D12, D13: WS2812B; LED_WS2812B_PLCC4_5.0x5.0mm_P3.2mm
D4, D8, D9: LED; LED_0603_1608Metric
F1: 0451015.MRL; 0451Series_LTF
FB1: FerriteBead; L_0603_1608Metric
J1, J2, J4: Power from PowerBoard; PinSocket_1x02_P2.54mm_Vertical
J3, J17, J18, J19: ST-Link; CONN14_3220-14_CNC
J5: Com from BackBoard; JST_PH_B4B-PH-K_1x04_P2.00mm_Vertical
J6: to TileBoard; JST_PH_B7B-PH-K_1x07_P2.00mm_Vertical
J7: to LidarBoard; PinSocket_1x04_P2.54mm_Vertical
J8: UnitV01; JST_PH_B4B-PH-K_1x04_P2.00mm_Vertical
J9, J11: GH-S37D; JST_ZH_B3B-ZR_1x03_P1.50mm_Vertical
J10: UnitV02; JST_PH_B4B-PH-K_1x04_P2.00mm_Vertical
J12, J13: LoadCell; JST_ZH_S4B-ZR-SM4A-TF_1x04-1MP_P1.50mm_Horizontal
J14: Power to TopBoard; AMASS_XT30U-F_1x02_P5.0mm_Vertical
J15: Comm to TopBoard; JST_PH_B4B-PH-K_1x04_P2.00mm_Vertical
J16: Conn_01x08_Socket; PinSocket_1x08_P2.54mm_Vertical
J20: to TopBoard; PinHeader_1x04_P2.54mm_Vertical
J21: USB_C_Receptacle_USB2.0_16P; USB_C_Receptacle_G-Switch_GT-USB-7010ASV
J22: LIDAR; JST_PH_S4B-PH-K_1x04_P2.00mm_Horizontal
J23: BNO055; PinSocket_1x02_P1.27mm_Vertical
J24, J26: UNITV; PinSocket_1x02_P1.27mm_Vertical
J25: to TileBoard; PinSocket_1x02_P1.27mm_Vertical
J27: SERVO; PinSocket_1x02_P1.27mm_Vertical
J28: NeoPixel; PinSocket_1x02_P1.27mm_Vertical
J29: to TopBoard; JST_PH_B7B-PH-K_1x07_P2.00mm_Vertical
J30, J31, J32: Power to TopBoard; PinHeader_1x02_P2.54mm_Vertical
J33: Power from BackBoard; AMASS_XT30U-F_1x02_P5.0mm_Vertical
LS1: PKLCS1212E4001-R1; PKLCS1212E4001R1
M1, M2, M3, M4: STS3032; JST_XH_B3B-XH-A_1x03_P2.50mm_Vertical
MD1: OKL-T_6-W12N-C; MURATA_OKL-T-6-W12N-C_0
MES1: Voltmeter_DC; JST_XH_B2B-XH-A_1x02_P2.50mm_Vertical
Q1, Q2, Q4, Q5, Q6: BSS138; SOT-23
Q3: TJ15S06M3L; TO-252-2
R1, R2, R4, R20, R21, R23, R24, R25, R28, R29: 10k; C_0603_1608Metric_Pad1.08x0.95mm_HandSolder
R3: 47; R_0603_1608Metric
R5, R6, R7, R8, R17, R36, R37, R41, R42: 10k; R_0603_1608Metric
R9, R12, R13, R16: 47k; R_0603_1608Metric
R10, R11, R14, R15: 20; R_0603_1608Metric
R18, R35, R40: 470; R_0603_1608Metric
R19, R26: 1k; R_0603_1608Metric
R22: 680; R_0603_1608Metric
R27, R30, R31, R32, R33, R34: 2.2k; C_0603_1608Metric_Pad1.08x0.95mm_HandSolder
R38, R39: 5.1k; R_0603_1608Metric
R43: 100; C_0603_1608Metric
R44: 100k; C_0603_1608Metric
R45: 20k; C_0603_1608Metric_Pad1.08x0.95mm_HandSolder
R46: 1.2k; C_0603_1608Metric_Pad1.08x0.95mm_HandSolder
R47: 1k; C_0603_1608Metric_Pad1.08x0.95mm_HandSolder
R48: 330; C_0603_1608Metric_Pad1.08x0.95mm_HandSolder
R49: 10; C_0603_1608Metric_Pad1.08x0.95mm_HandSolder
SW1, SW4, SW7, SW9: RESET_SWITCH; SW_SKRPACE010
SW2, SW5, SW8, SW10: MODE_SWITCH; SSSS213202
SW3, SW6: B-12CCP
SW11, SW12: TC-06104-043E; SW_Push_1P1T_NO_6x6mm_H9.5mm
U1, U3, U11, U13: PinSocket_1x06_P2.54mm_Vertical
U2, U15, U17, U22: Sit2001B; SOT-23-5
U4: STM32H723ZGTx; LQFP-144_20x20mm_P0.5mm
U5, U12: AE-BNO055-BO
U6, U8: NJU77551F; SOT-23-5
U7: MOUDLE-SEEEDUINO-XIAO-ESP32C3; MOUDLE14P-SMD-2.54-21X17.8MM
U9: MIC5219-5.0YM5-TR; SOT-23-5
U10: AZ1117CH-3.3TRG1; DIODES_AZ1117CH-3.3TRG1_0
U14, U16, U21: STM32F446RET6; LQFP-64_10x10mm_P0.5mm
U18: MAX3485; SOIC-8_3.9x4.9mm_P1.27mm
U19: RT9080-33GJ5; TSOT-23-5
U20: CH340E; MSOP-10_3x3mm_P0.5mm
U23: S11059
U24: LT1085CM-3.3#PBF; TO-263-3_TabPin2

Connections:
+3.3V: C1.1, C2.1, C3.1, C4.1, C5.1, C6.1, C7.1, C8.1, C9.1, C10.1, C11.1, C12.1, C13.1, C14.1, C19.1, C23.1, C26.1, C27.1, C28.1, C29.1, C30.1, C31.1, C32.1, C34.1, C37.1, C38.1, C39.1, C40.1, C41.1, C42.1, C43.1, C45.1, C46.1, C49.1, C50.1, C51.1, C52.1, C53.1, C54.1, C55.1, C56.1, C61.1, C64.1, C68.1, FB1.2, J2.1, J3.3 (VCC), J6.1, J17.3 (VCC), J18.3 (VCC), J19.3 (VCC), J29.1, J31.1, Q1.2 (G), Q2.2 (G), Q5.2 (G), Q6.1 (G), R1.1, R4.1, R6.1, R8.1, R20.1, R23.1, R25.1, R27.1, R28.1, R30.1, R31.1, R32.1, R33.1, R36.1, R42.1, U1.3 (VDD), U2.4 (VDD), U3.3 (VDD), U4.6 (VBAT), U4.17 (VDD), U4.30 (VDD), U4.39 (VDD), U4.52 (VDD), U4.62 (VDD), U4.72 (VDD), U4.84 (VDD), U4.95 (VDD33USB), U4.108 (VDD), U4.121 (VDD), U4.131 (VDD), U4.144 (VDD), U5.1 (VCC), U10.2 (OUTPUT), U11.3 (VDD), U12.1 (VCC), U13.3 (VDD), U14.1 (VBAT), U14.13 (VDDA), U14.19 (VDD), U14.32 (VDD), U14.48 (VDD), U14.64 (VDD), U15.4 (VDD), U16.1 (VBAT), U16.13 (VDDA), U16.19 (VDD), U16.32 (VDD), U16.48 (VDD), U16.64 (VDD), U17.4 (VDD), U18.8 (VCC), U19.5 (VOUT), U21.1 (VBAT), U21.13 (VDDA), U21.19 (VDD), U21.32 (VDD), U21.48 (VDD), U21.64 (VDD), U22.4 (VDD), U23.1 (VDD), U24.2 (VO)
+5V: A1.1, A1.4, C24.1, C57.1, C59.1, C66.1, D1.1 (VDD), D2.1 (VDD), D3.1 (VDD), D5.1 (VDD), D6.1 (VDD), D7.1 (VDD), D10.1 (VDD), D11.1 (VDD), D12.1 (VDD), D13.1 (VDD), J1.1, J4.1, J6.2, J7.1, J8.2, J9.2, J10.2, J11.2, J16.1, J20.1, J21.A4 (VBUS), J21.A9 (VBUS), J21.B4 (VBUS), J21.B9 (VBUS), J22.1, J29.2, J30.1, J32.1, LS1.1, MD1.4 (VOUT), MD1.5 (SENSE), R5.1, R7.1, R22.1, R24.1, R35.1, R41.1, R46.1, U7.14 (5V), U9.5 (OUT), U19.1 (VIN), U19.3 (EN), U20.7 (VCC)
+7.5V: C22.1, C65.1, C67.1, J14.1, J33.1, M1.2 (V1), M2.2 (V1), M3.2 (V1), M4.2 (V1), MD1.2 (VIN), Q3.1 (D), R18.1, R19.2, R26.2, R45.1, U9.1 (IN), U9.3 (EN), U10.3 (INPUT), U24.3 (VI)
/Back/CS: J16.6, U16.41 (PA8)
/Back/DC: J16.8, U16.26 (PB0)
/Back/DIN: Q5.3 (S), R25.2, U16.28 (PB2)
/Back/HSE: C36.1, U14.5 (PH0), U15.5 (OUT)
/Back/HSE2: C47.1, U16.5 (PH0), U17.5 (OUT)
/Back/MISO: J16.5, U16.23 (PA7)
/Back/MOSI: J16.4, U16.22 (PA6)
/Back/NRST: C33.2, J17.12 (~RST), SW4.2, U14.7 (NRST)
/Back/NRST2: C44.2, J18.12 (~RST), SW7.2, U16.7 (NRST)
/Back/PC2: U14.10 (PC2), U18.2 (~RE), U18.3 (DE)
/Back/PWM: Q4.2 (G), U16.27 (PB1)
/Back/RX: J15.2, U16.17 (PA3)
/Back/RX1: J17.13 (VCP_RX), U14.43 (PA10)
/Back/RX2: U14.17 (PA3), U18.1 (RO)
/Back/RX3: J15.4, U14.25 (PC5)
/Back/RX4: J18.13 (VCP_RX), U16.43 (PA10)
/Back/SCK: J16.3, U16.21 (PA5)
/Back/SCL: U11.6 (SCL), U12.4 (SCL/R), U13.6 (SCL), U14.41 (PA8)
/Back/SDA: U11.5 (SDA), U12.3 (SDA/T), U13.5 (SDA), U14.40 (PC9)
/Back/SWCLK: J17.6 (JCLK/SWCLK), U14.49 (PA14)
/Back/SWCLK2: J18.6 (JCLK/SWCLK), U16.49 (PA14)
/Back/SWDIO: J17.4 (JTMS/SWDIO), U14.46 (PA13)
/Back/SWDIO2: J18.4 (JTMS/SWDIO), U16.46 (PA13)
/Back/SWO: J17.8 (JTDO/SWO), U14.55 (PB3)
/Back/TX: J15.1, U16.16 (PA2)
/Back/TX1: J17.14 (VCP_TX), U14.42 (PA9)
/Back/TX2: U14.16 (PA2), U18.4 (DI)
/Back/TX3: J15.3, U14.29 (PB10)
/Back/TX4: J18.14 (VCP_TX), U16.42 (PA9)
/Back/XSHUT1: U13.2 (XSHUT), U14.37 (PC6)
/Back/XSHUT2: U11.2 (XSHUT), U14.58 (PB6)
/Lidar/HSE: C63.1, U21.5 (PH0), U22.5 (OUT)
/Lidar/IN: Q6.2 (S), R41.2, U21.61 (PB8)
/Lidar/IN2: J28.1, U21.35 (PB14)
/Lidar/IN3: J28.2, U21.36 (PB15)
/Lidar/NRST: C58.2, J19.12 (~RST), SW9.2, U21.7 (NRST)
/Lidar/PWM: J27.1, U21.22 (PA6)
/Lidar/PWM2: J27.2, U21.23 (PA7)
/Lidar/RX1: J19.13 (VCP_RX), U21.43 (PA10)
/Lidar/RX2: J22.2, U21.17 (PA3)
/Lidar/RX3: J20.4, U21.25 (PC5)
/Lidar/RX4: U20.8 (TXD), U21.15 (PA1)
/Lidar/RX5: J24.2, U21.54 (PD2)
/Lidar/RX6: J26.2, U21.38 (PC7)
/Lidar/SCL: J23.1, U21.58 (PB6)
/Lidar/SCL2: J25.1, U21.41 (PA8)
/Lidar/SDA: J23.2, U21.59 (PB7)
/Lidar/SDA2: J25.2, U21.40 (PC9)
/Lidar/SWCLK: J19.6 (JCLK/SWCLK), U21.49 (PA14)
/Lidar/SWDIO: J19.4 (JTMS/SWDIO), U21.46 (PA13)
/Lidar/SWO: J19.8 (JTDO/SWO), U21.55 (PB3)
/Lidar/TX1: J19.14 (VCP_TX), U21.42 (PA9)
/Lidar/TX2: J22.4, U21.16 (PA2)
/Lidar/TX3: J20.3, U21.29 (PB10)
/Lidar/TX4: U20.9 (RXD), U21.14 (PA0)
/Lidar/TX5: J24.1, U21.53 (PC12)
/Lidar/TX6: J26.1, U21.37 (PC6)
/Tile/ADC: A1.3, J29.7, R44.1
/Tile/IN: D12.4 (DIN), J29.6
/Tile/SCL: J29.4, U23.3 (SCL)
/Tile/SDA: J29.5, U23.4 (SDA)
/Top/AD1: R9.2, U4.44 (PC4), U6.5
/Top/AD2: R13.2, U4.49 (PF11), U8.5
/Top/AD3: J6.7, U4.53 (PF13)
/Top/DIN1: Q2.3 (S), R8.2, U4.42 (PA6)
/Top/DIN4: Q1.3 (S), R5.2, U4.4 (PE5)
/Top/HSE: C18.1, U2.5 (OUT), U4.23 (PH0)
/Top/NRST: C17.2, J3.12 (~RST), SW1.2, U4.25 (NRST)
/Top/PWM1: J9.1, U4.60 (PE9)
/Top/PWM2: J11.1, U4.41 (PA5)
/Top/RX1: J3.13 (VCP_RX), U4.76 (PB15)
/Top/RX2: J7.3, U4.37 (PA3)
/Top/RX3: J5.1, U4.69 (PB10)
/Top/RX4: J5.3, U4.35 (PA1)
/Top/RX5: J8.3, U4.73 (PB12)
/Top/RX6: J10.3, U4.97 (PC7)
/Top/RX7: U4.18 (PF6), U7.7 (PB08_A6_D6_TX)
/Top/SCL: J6.4, U1.6 (SCL), U3.6 (SCL), U4.54 (PF14), U5.4 (SCL/R)
/Top/SDA: J6.5, U1.5 (SDA), U3.5 (SDA), U4.55 (PF15), U5.3 (SDA/T)
/Top/SWCLK: J3.6 (JCLK/SWCLK), U4.109 (PA14(JTCK)
/Top/SWDIO: J3.4 (JTMS/SWDIO), U4.105 (PA13(JTMS)
/Top/TX1: J3.14 (VCP_TX), U4.75 (PB14)
/Top/TX2: J7.4, U4.36 (PA2)
/Top/TX3: J5.2, U4.70 (PB11)
/Top/TX4: J5.4, U4.34 (PA0)
/Top/TX5: J8.4, U4.74 (PB13)
/Top/TX6: J10.4, U4.96 (PC6)
/Top/TX7: U4.19 (PF7), U7.8 (PB09_A7_D7_RX)
/Top/XSHUT1: U1.2 (XSHUT), U4.56 (PG0)
/Top/XSHUT2: U3.2 (XSHUT), U4.57 (PG1)
GND: BT1.2 (-), C1.2, C2.2, C3.2, C4.2, C5.2, C6.2, C7.2, C8.2, C9.2, C10.2, C11.2, C12.2, C13.2, C14.2, C15.2, C16.2, C17.1, C18.2, C19.2, C20.1, C21.1, C22.2, C23.2, C24.2, C25.2, C26.2, C27.2, C28.2, C29.2, C30.2, C31.2, C32.2, C33.1, C34.2, C35.2, C36.2, C37.2, C38.2, C39.2, C40.2, C41.2, C42.2, C43.2, C44.1, C45.2, C46.2, C47.2, C48.2, C49.2, C50.2, C51.2, C52.2, C53.2, C54.2, C55.2, C56.2, C57.2, C58.1, C59.2, C60.1, C61.2, C62.2, C63.2, C64.2, C65.2, C66.2, C67.2, C68.2, D1.3 (VSS), D2.3 (VSS), D3.3 (VSS), D4.1 (K), D5.3 (VSS), D6.3 (VSS), D7.3 (VSS), D8.1 (K), D9.1 (K), D10.3 (VSS), D11.3 (VSS), D12.3 (VSS), D13.3 (VSS), J1.2, J2.2, J3.5 (GND), J3.7 (GND), J3.11 (GNDDetect), J4.2, J6.3, J7.2, J8.1, J9.3, J10.1, J11.3, J12.4, J13.4, J14.2, J16.2, J17.5 (GND), J17.7 (GND), J17.11 (GNDDetect), J18.5 (GND), J18.7 (GND), J18.11 (GNDDetect), J19.5 (GND), J19.7 (GND), J19.11 (GNDDetect), J20.2, J21.A1 (GND), J21.A12 (GND), J21.B1 (GND), J21.B12 (GND), J22.3, J29.3, J30.2, J31.2, J32.2, J33.2, M1.3 (GND), M2.3 (GND), M3.3 (GND), M4.3 (GND), MD1.1 (~ON/OFF_CONTROL), MD1.3 (1_GROUND), MD1.7 (2_GROUND), MES1.1 (-), Q4.3 (S), R2.1, R12.2, R16.2, R21.1, R29.1, R34.2, R37.1, R38.2, R39.2, R43.2, R44.2, R45.2, R46.2, R49.2, SW1.1, SW3.2 (B), SW3.6 (K), SW4.1, SW6.3 (C), SW6.6 (K), SW7.1, SW9.1, SW11.1, SW12.1, U1.4 (GND), U2.1 (GND), U3.4 (GND), U4.16 (VSS), U4.31 (VSSA), U4.38 (VSS), U4.51 (VSS), U4.61 (VSS), U4.83 (VSS), U4.94 (VSS), U4.107 (VSS), U4.120 (VSS), U4.130 (VSS), U5.2 (GND), U5.7 (GND), U6.4 (V-), U7.13 (GND), U8.4 (V-), U9.2 (GND), U10.1 (GND), U11.4 (GND), U12.2 (GND), U12.7 (GND), U13.4 (GND), U14.12 (VSSA), U14.18 (VSS), U14.31 (VSS), U14.47 (VSS), U14.63 (VSS), U15.1 (GND), U16.12 (VSSA), U16.18 (VSS), U16.31 (VSS), U16.47 (VSS), U16.63 (VSS), U17.1 (GND), U18.5 (GND), U19.2 (GND), U20.3 (GND), U21.12 (VSSA), U21.18 (VSS), U21.31 (VSS), U21.47 (VSS), U21.63 (VSS), U22.1 (GND), U23.2 (GND), U24.1 (GND)
unnamed: A1.2, R43.1
unnamed: BT1.1 (+), F1.1, MES1.2 (+)
unnamed: C20.2, U4.71 (VCAP)
unnamed: C21.2, U4.106 (VCAP)
unnamed: D1.4 (DIN), Q2.1 (D), R7.2
unnamed: D1.2 (DOUT), D2.4 (DIN)
unnamed: D2.2 (DOUT), D3.4 (DIN)
unnamed: D4.2 (A), R18.2
unnamed: D5.4 (DIN), Q5.1 (D), R24.2
unnamed: D5.2 (DOUT), D6.4 (DIN)
unnamed: D6.2 (DOUT), D7.4 (DIN)
unnamed: D8.2 (A), R35.2
unnamed: D9.2 (A), R40.1
unnamed: D10.4 (DIN), Q6.3 (D), R42.2
unnamed: D10.2 (DOUT), D11.4 (DIN)
unnamed: D12.2 (DOUT), D13.4 (DIN)
unnamed: J6.6, Q1.1 (D), R6.2
unnamed: J12.2, R10.1
unnamed: J12.3, R11.1
unnamed: J13.2, R14.1
unnamed: J13.3, R15.1
unnamed: J21.A5 (CC1), R38.1
unnamed: J21.B5 (CC2), R39.1
unnamed: M1.1 (S), M2.1 (S), M3.1 (S), M4.1 (S), R27.2, R30.2, R31.2, R32.2, U18.6 (A)
unnamed: MD1.6 (TRIM), R47.1
unnamed: Q3.2 (G), R17.1, SW3.1 (A)
unnamed: F1.2, Q3.3 (S), R17.2
unnamed: LS1.2, Q4.1 (D), R22.2
unnamed: R19.1, SW3.5 (A)
unnamed: R23.2, SW6.1 (A)
unnamed: R26.1, SW6.5 (A)
unnamed: R47.2, R48.1
unnamed: R48.2, R49.1
unnamed: R1.2, SW2.1 (A)
unnamed: SW2.2 (B), U4.138 (BOOT0)
unnamed: R2.2, SW2.3 (C)
unnamed: R20.2, SW5.1 (A)
unnamed: SW5.2 (B), U14.60 (BOOT0)
unnamed: R21.2, SW5.3 (C)
unnamed: SW6.2 (B), U14.33 (PB12)
unnamed: R28.2, SW8.1 (A)
unnamed: SW8.2 (B), U16.60 (BOOT0)
unnamed: R29.2, SW8.3 (C)
unnamed: R36.2, SW10.1 (A)
unnamed: SW10.2 (B), U21.60 (BOOT0)
unnamed: R37.2, SW10.3 (C)
unnamed: R4.2, U4.143 (PDR_ON)
unnamed: R3.2, U4.32 (VREF+)
unnamed: R11.2, R12.1, U6.1 (+)
unnamed: R9.1, R10.2, U6.2 (-)
unnamed: R15.2, R16.1, U8.1 (+)
unnamed: R13.1, R14.2, U8.2 (-)
unnamed: C25.1, U9.4 (BYP)
unnamed: C35.1, U14.30 (VCAP_1)
unnamed: C48.1, U16.30 (VCAP_1)
unnamed: R33.2, R34.1, U18.7 (B)
unnamed: R40.2, U20.6 (TNOW)
unnamed: J21.A6 (D+), J21.B6 (D+), U20.1 (UD+)
unnamed: J21.A7 (D-), J21.B7 (D-), U20.2 (UD-)
unnamed: C60.2, U20.10 (V3)
unnamed: U20.4 (~RTS), U20.5 (~CTS)
unnamed: SW11.2, U21.33 (PB12)
unnamed: SW12.2, U21.34 (PB13)
unnamed: C62.1, U21.30 (VCAP_1)
VDDA: C15.1, C16.1, FB1.1, J12.1, J13.1, R3.1, U4.33 (VDDA), U6.3 (V+), U8.3 (V+)
