FornaxRRSC/RCJ2025_Hardware/(commit log)

2024-11-09 after hacchu BackBoard
    [BackBoard.kicad_sch, LidarBoard.kicad_sch, LiderBoard.kicad_sch, PowerBoard.kicad_sch, Rev.1.kicad_pcb, Rev.1.kicad_sch, TileBoard.kicad_sch, TopBoard.kicad_sch]
2024-11-29 after ordered TileBoard Rev.1 and PowerBoard Rev.1
    [BackBoard.kicad_sch, LidarBoard.kicad_sch, LiderBoard.kicad_sch, PowerBoard.kicad_sch, Rev.1.kicad_sch, TileBoard.kicad_sch, TopBoard.kicad_sch, bom.csv]
2024-12-26 Lidar基板Rev.2発注
    [BackBoard.kicad_sch, LidarBoard.kicad_sch, PowerBoard.kicad_sch, TileBoard.kicad_sch, TopBoard.kicad_sch, bom.csv, designators.csv, positions.csv]
2025-01-05 LiDAR基板Rev.2修正
    [BackBoard.kicad_sch, LidarBoard.kicad_sch, Rev.1.kicad_pcb, bom.csv, designators.csv, positions.csv]
2025-01-05 LiDAR基板Rev.2修正v2
    [LidarBoard.kicad_sch, Rev.1.kicad_pcb]
2025-02-04 メイン基板Rev.2完成
    [BackBoard.kicad_sch, LidarBoard.kicad_sch, PowerBoard.kicad_sch, Rev.1.kicad_pcb, TileBoard.kicad_sch, TopBoard.kicad_sch, bom.csv, designators.csv]
2025-02-19 後ろ基板Rev.2完成
    [BackBoard.kicad_sch]
2025-05-04 メイン基板Rev.3
    [BackBoard.kicad_sch, Final.kicad_pcb, Final.kicad_sch, LidarBoard.kicad_sch, LiderBoard.kicad_sch, MainBoard.kicad_sch, PowerBoard.kicad_sch, Rev.1.kicad_sch]
2025-05-04 LiDAR基板Rev.3コネクタ配置
    [Final.kicad_pcb, LidarBoard.kicad_sch, MainBoard.kicad_sch, TileBoard.kicad_sch]
2025-05-13 後ろ基板Rev.2
    [BackBoard.kicad_sch, Final.kicad_pcb, LidarBoard.kicad_sch, MainBoard.kicad_sch, TileBoard-Rev2.step, TileBoard.kicad_sch, bom.csv, designators.csv]
2025-07-24 README.md 既知の欠陥を追加
